Khazaril/zine-tutorial/duckling/renders/duckling_front34.png

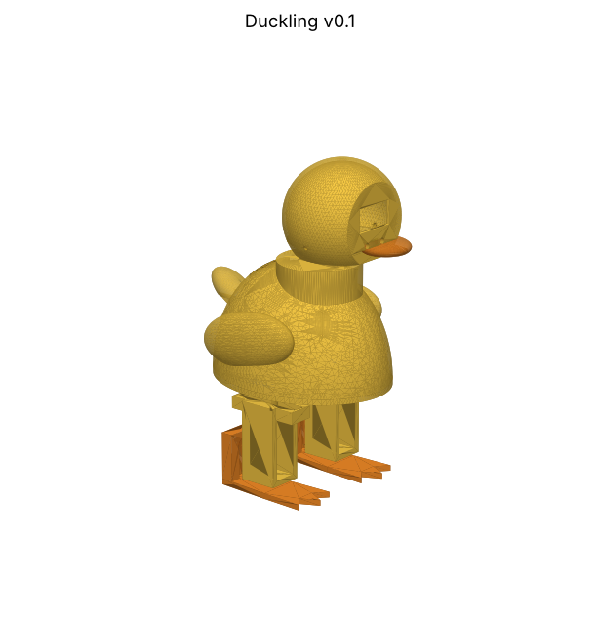
duckling/renders/duckling_front34.png
