Khazaril/zine-tutorial/duckling/renders/duckling_front.png

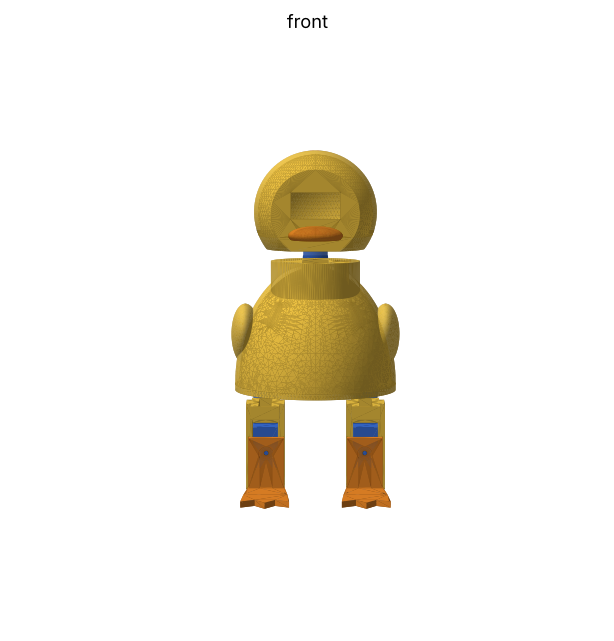
duckling/renders/duckling_front.png
