Khazaril/zine-tutorial/duckling/renders/duckling_internals.png

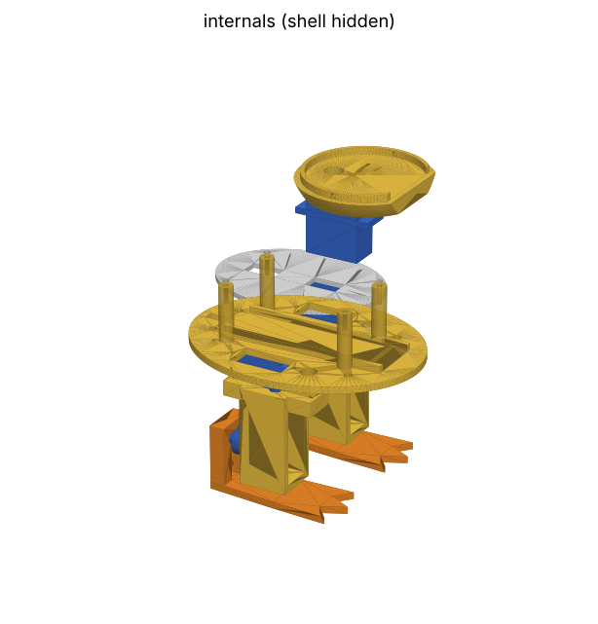
duckling/renders/duckling_internals.png
