Khazaril/zine-tutorial/duckling/renders/impression_back.png

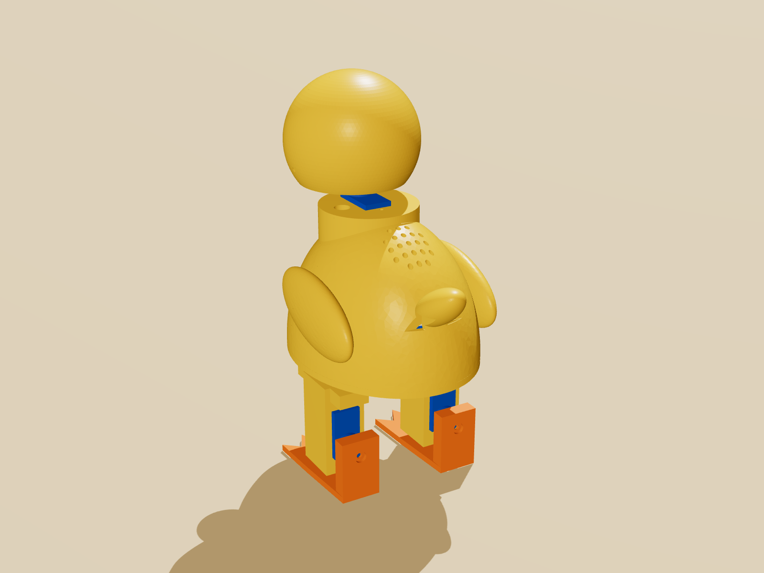
duckling/renders/impression_back.png
