Khazaril/zine-tutorial/duckling/renders/impression_exploded.png

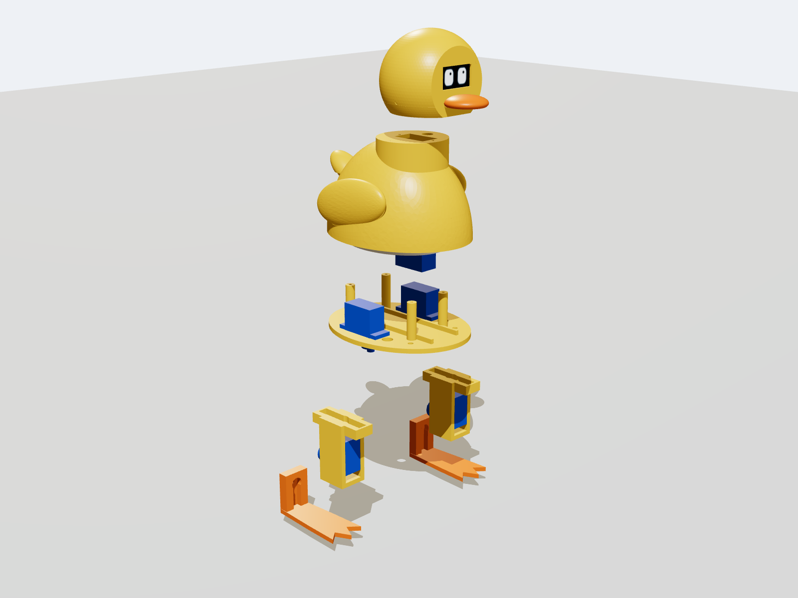
duckling/renders/impression_exploded.png
