Khazaril/zine-tutorial/duckling/renders/impression_front.png

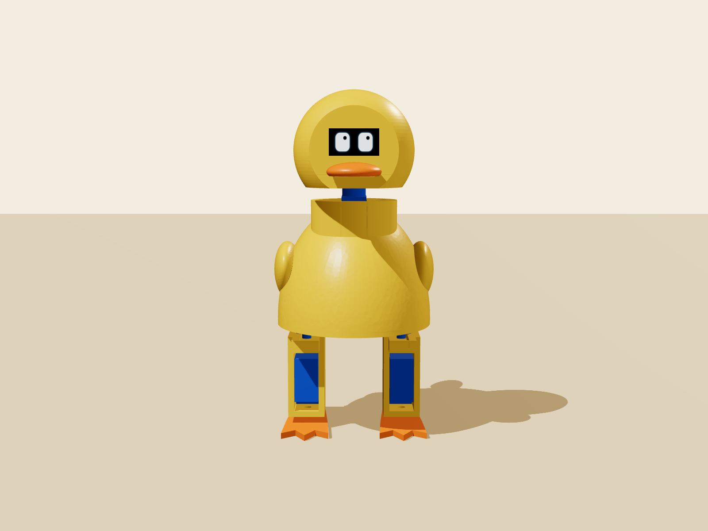
duckling/renders/impression_front.png
