Khazaril/zine-tutorial/duckling/renders/impression_side.png

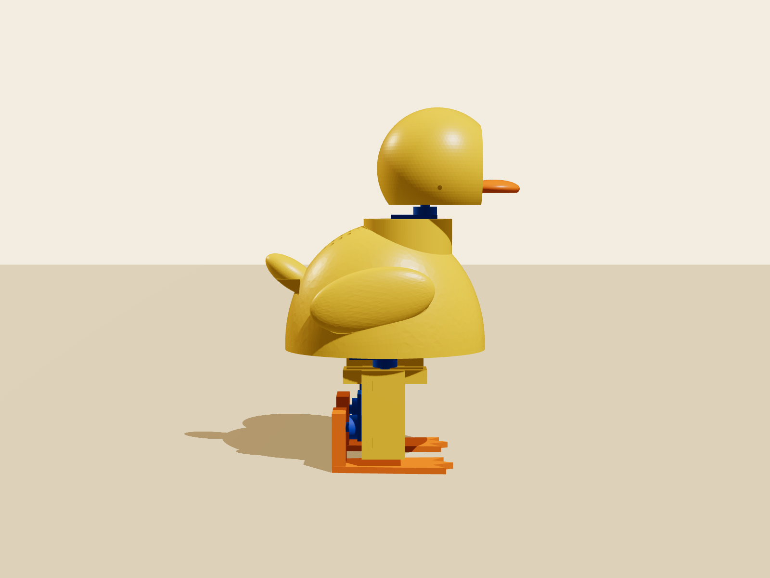
duckling/renders/impression_side.png
