Khazaril/zine-tutorial/duckling/renders/impression_waddle.png

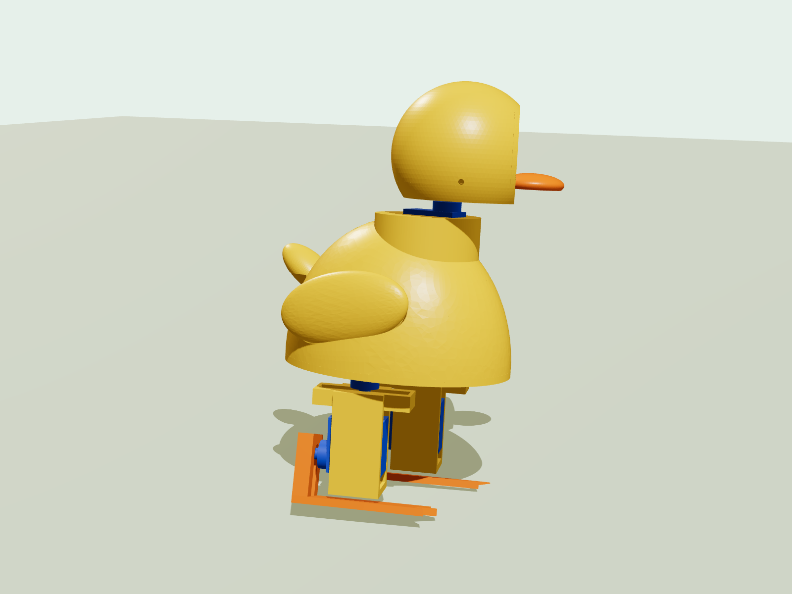
duckling/renders/impression_waddle.png
