Khazaril/zine-tutorial/duckling/stl/assembly/_servo2.stl

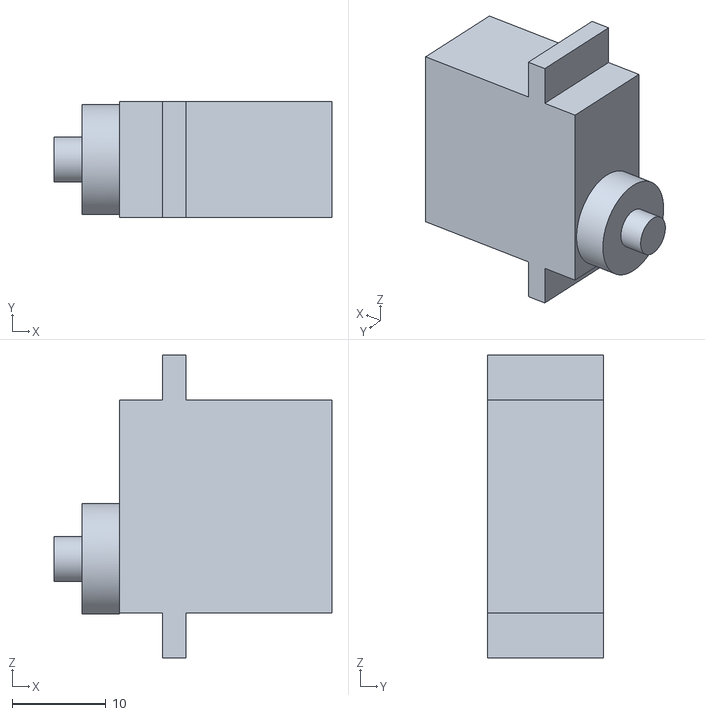
[picture p11: CAD file, 2026-10-23]
duckling/stl/assembly/_servo2.stl
29.7 x 12.4 x 32.4
