Khazaril/zine-tutorial/duckling/stl/beak.stl

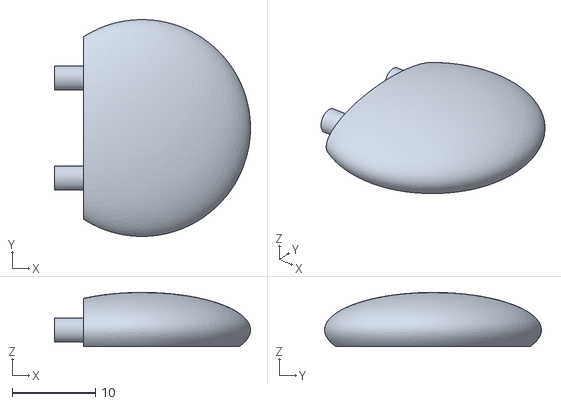
[picture p12: CAD file, 2026-10-23]
duckling/stl/beak.stl
23.5 x 26.0 x 6.50
