Khazaril/zine-tutorial/duckling/stl/assembly/foot_right.stl

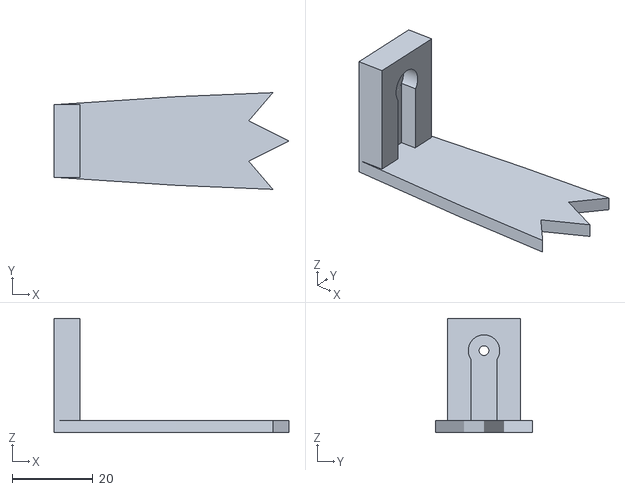
[picture p13: CAD file, 2026-10-23]
duckling/stl/assembly/foot_right.stl
58.3 x 24.0 x 28.4
