Khazaril/zine-tutorial/duckling/stl/shell.stl

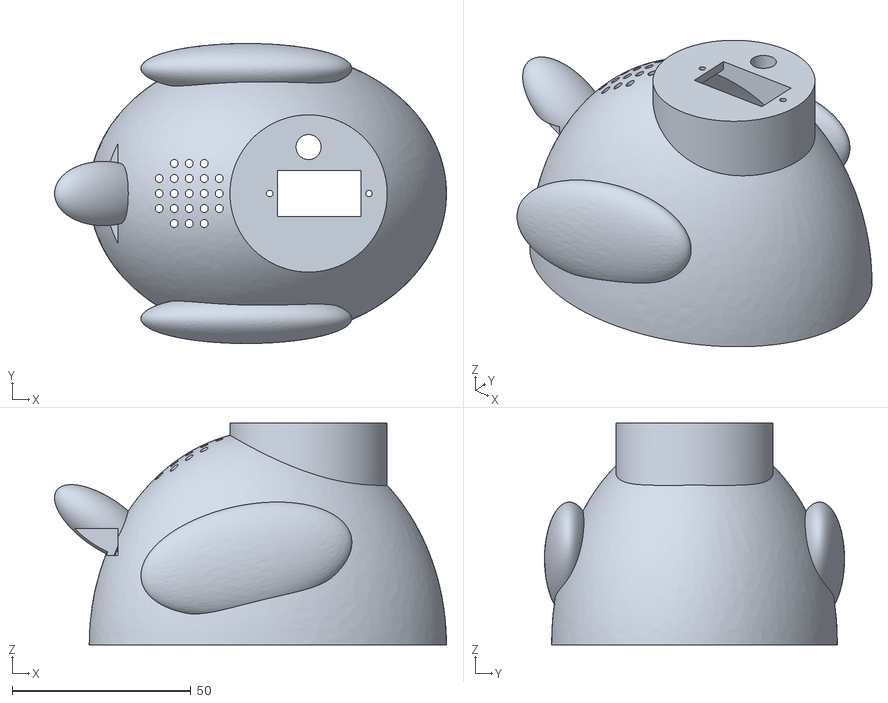
[picture p14: CAD file, 2026-10-23]
duckling/stl/shell.stl
109.7 x 84.0 x 62.0
