Khazaril/zine-tutorial/duckling/stl/assembly/tray.stl

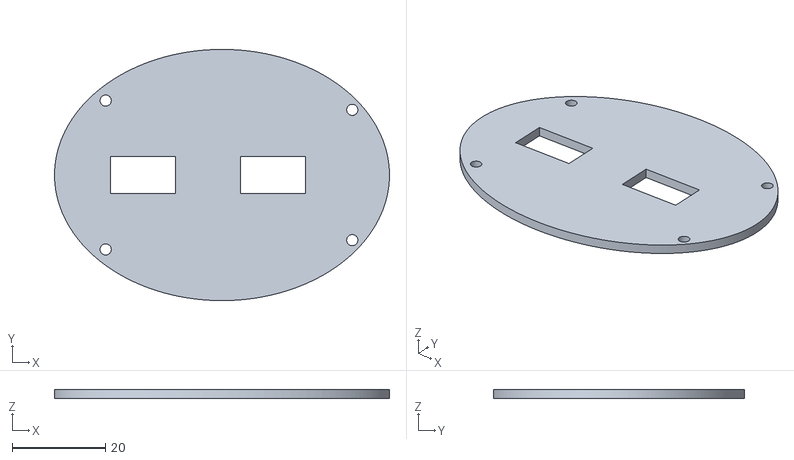
[picture p15: CAD file, 2026-10-23]
duckling/stl/assembly/tray.stl
72.0 x 54.0 x 2.00
