Khazaril/zine-tutorial/duckling/stl/chassis.stl

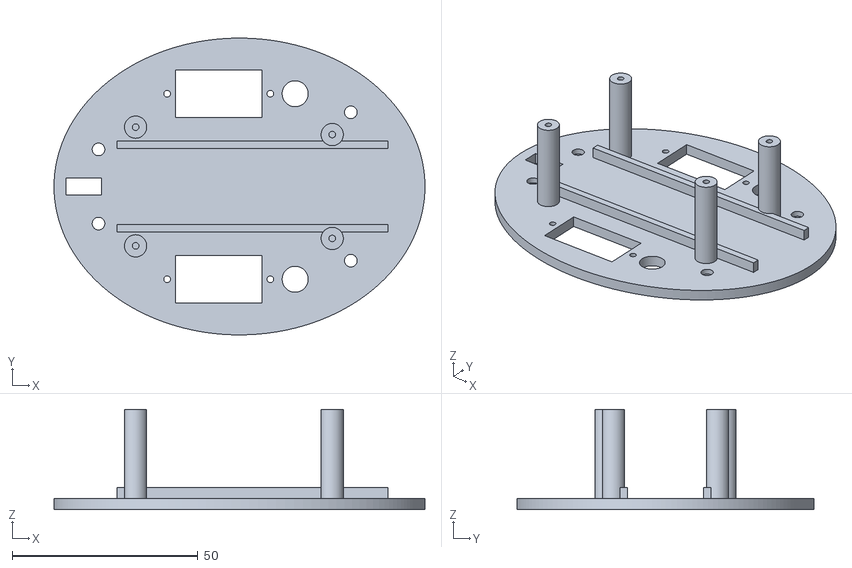
[picture p16: CAD file, 2026-10-23]
duckling/stl/chassis.stl
100.0 x 80.0 x 27.0
