Khazaril/zine-tutorial/duckling/stl/assembly/head_shell.stl

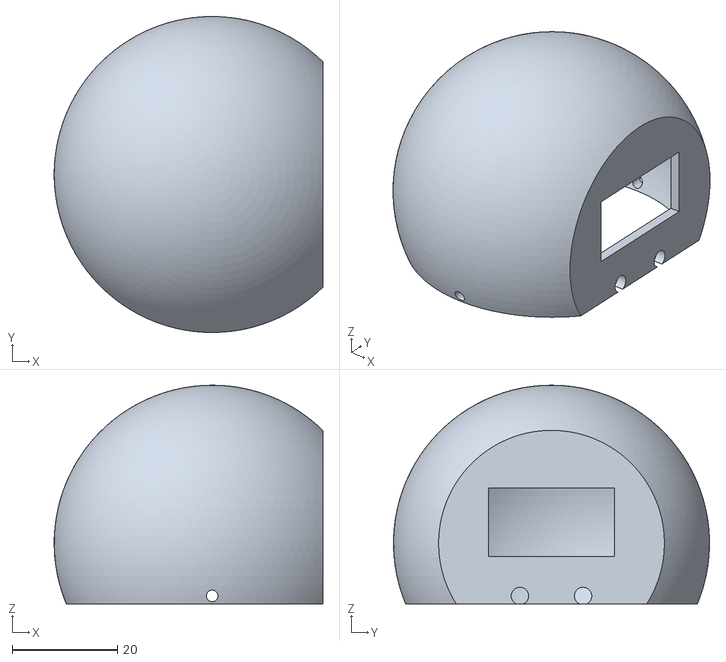
[picture p17: CAD file, 2026-10-23]
duckling/stl/assembly/head_shell.stl
51.0 x 60.0 x 41.5
