Khazaril/zine-tutorial/duckling/stl/assembly/leg_right.stl

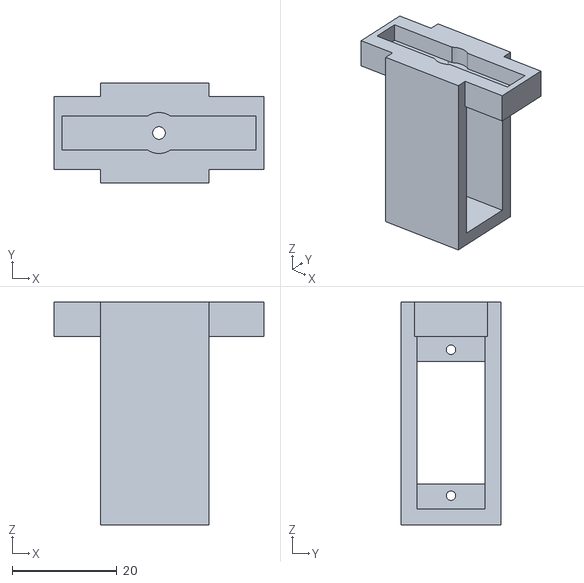
[picture p18: CAD file, 2026-10-23]
duckling/stl/assembly/leg_right.stl
40.0 x 19.0 x 42.4
