Khazaril/zine-tutorial/duckling/stl/head_shell.stl

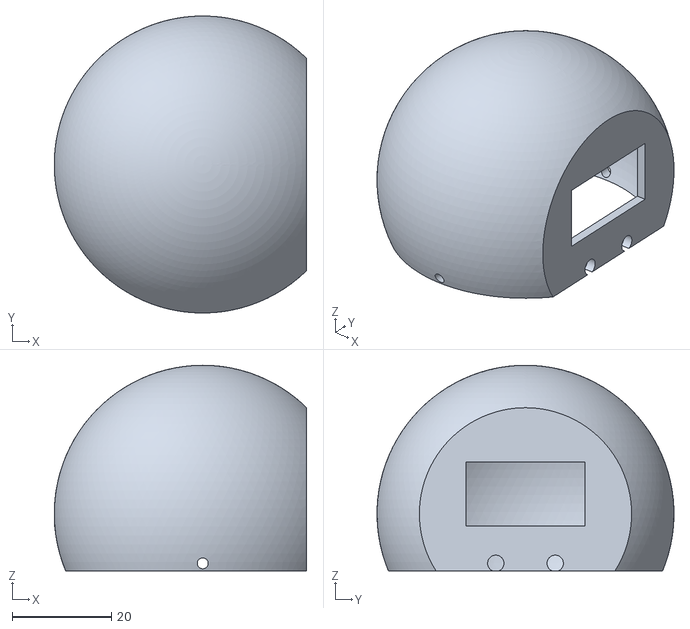
[picture p19: CAD file, 2026-10-23]
duckling/stl/head_shell.stl
51.0 x 60.0 x 41.5
