Khazaril/zine-tutorial/duckling/stl/head_base.stl

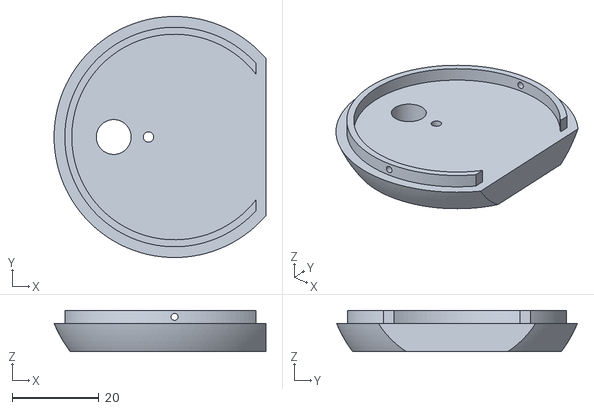
[picture p20: CAD file, 2026-10-23]
duckling/stl/head_base.stl
48.7 x 55.4 x 9.50
