Khazaril/zine-tutorial/(list of files, cad)

Other CAD files:
duckling/stl/tray.stl
duckling/stl/leg_left.stl
duckling/stl/assembly/_servo3.stl
duckling/stl/leg_right.stl
duckling/stl/assembly/chassis.stl
duckling/stl/foot_right.stl
duckling/stl/assembly/_servo1.stl
duckling/stl/assembly/shell.stl
duckling/stl/assembly/leg_left.stl
duckling/stl/assembly/beak.stl
duckling/stl/assembly/foot_left.stl
duckling/stl/assembly/head_base.stl
duckling/stl/assembly/_servo0.stl
duckling/stl/assembly/_servo4.stl
